Montso/Pi-HAT/Additional Libraries/74LVC125APW_118/74LVC125APW_118.step

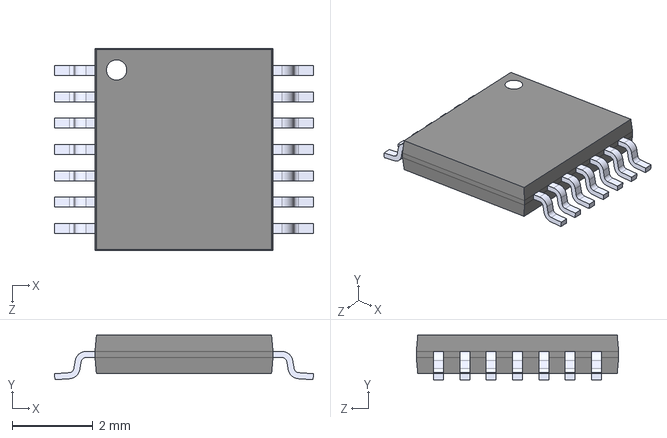
[picture p1: CAD file, 2022-10-23]
Additional Libraries/74LVC125APW_118/74LVC125APW_118.step
6.40 x 1.10 x 5.00 mm
