Montso/Pi-HAT/Additional Libraries/ADC108S022CIMTX_NOPB/ADC108S022CIMTX_NOPB.step

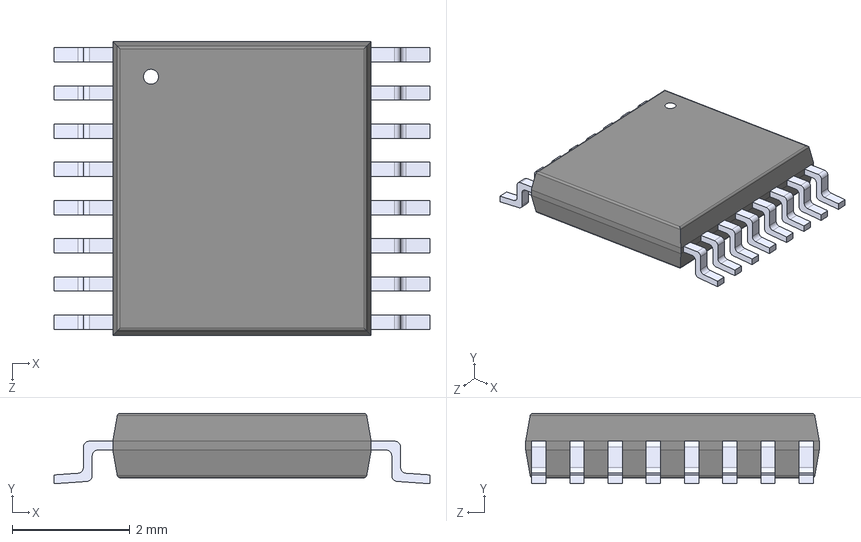
[picture p2: CAD file, 2023-12-06]
Additional Libraries/ADC108S022CIMTX_NOPB/ADC108S022CIMTX_NOPB.step
6.40 x 1.20 x 5.00 mm
