Montso/Pi-HAT/Additional Libraries/TMP235A2DCKR/TMP235A2DCKR.step

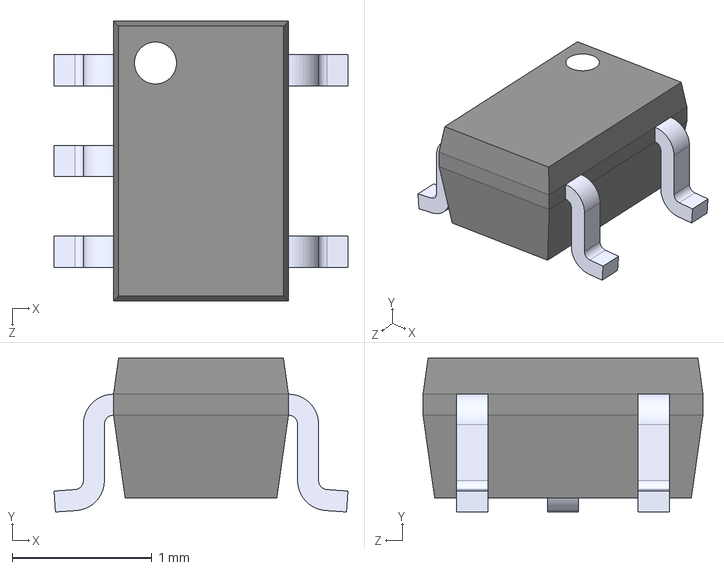
[picture p3: CAD file, 2023-12-06]
Additional Libraries/TMP235A2DCKR/TMP235A2DCKR.step
2.10 x 1.10 x 2.00 mm
