Montso/Pi-HAT/Pi HAT.kicad_pcb

## KiCad design Pi HAT.kicad_pcb (2024-07-01)

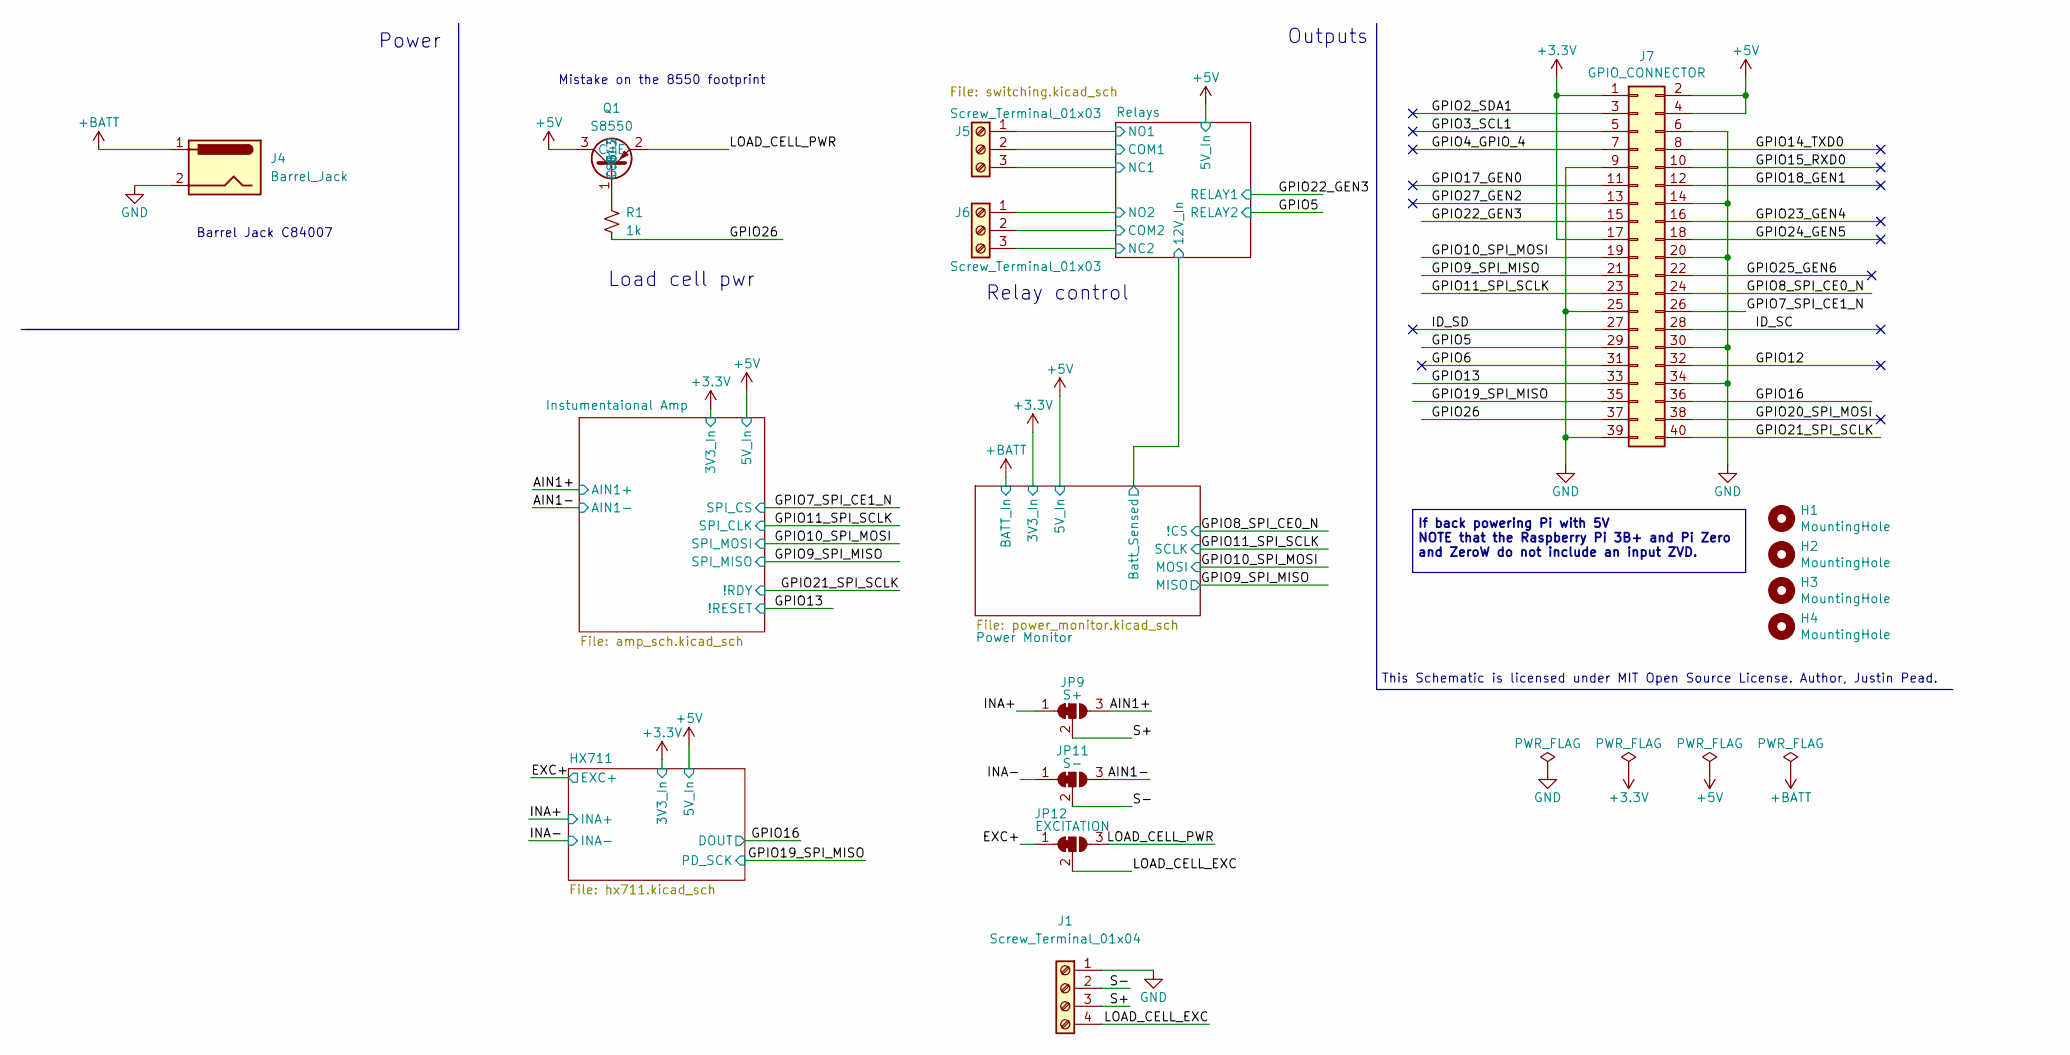
[picture p4: schematic Pi HAT.kicad_sch, Raspberry Pi Zero Intrumentation HAT]

Parts:
H1, H2, H3, H4: MountingHole; MountingHole_2.7mm_M2.5_uHAT_RPi
J1: Screw_Terminal_01x04; TerminalBlock_Phoenix_PT-1,5-4-3.5-H_1x04_P3.50mm_Horizontal; LCSC C5144867
J4: Barrel_Jack; Barrel_Jack_2A_C84007; LCSC C84007
J5, J6: Screw_Terminal_01x03; TerminalBlock_Phoenix_PT-1,5-3-3.5-H_1x03_P3.50mm_Horizontal; LCSC C3816291
J7: GPIO_CONNECTOR; PinSocket_2x20_P2.54mm_Vertical_Centered_Anchor
JP9: S+; SolderJumper-3_P1.3mm_Bridged2Bar12_RoundedPad1.0x1.5mm
JP11: S-; SolderJumper-3_P1.3mm_Bridged2Bar12_RoundedPad1.0x1.5mm
JP12: EXCITATION; SolderJumper-3_P1.3mm_Bridged2Bar12_RoundedPad1.0x1.5mm
Q1: S8550; SOT-23; LCSC C8542
R1: 1k; R_0402_1005Metric; LCSC C11702

Connections:
+3.3V: J7.1, J7.17; also elsewhere on the board
+5V: J7.2, J7.4, Q1.3 (C); also elsewhere on the board
+BATT: J4.1; also elsewhere on the board
/AIN1+: JP9.3 (B); also elsewhere on the board
/AIN1-: JP11.3 (B); also elsewhere on the board
/EXC+: JP12.1 (A); also elsewhere on the board
/GPIO2_SDA1: J7.3
/GPIO3_SCL1: J7.5
/GPIO4_GPIO_4: J7.7
/GPIO5: J7.29; also elsewhere on the board
/GPIO6: J7.31
/GPIO7_SPI_CE1_N: J7.26; also elsewhere on the board
/GPIO8_SPI_CE0_N: J7.24; also elsewhere on the board
/GPIO9_SPI_MISO: J7.21; also elsewhere on the board
/GPIO10_SPI_MOSI: J7.19; also elsewhere on the board
/GPIO11_SPI_SCLK: J7.23; also elsewhere on the board
/GPIO12: J7.32
/GPIO13: J7.33; also elsewhere on the board
/GPIO14_TXD0: J7.8
/GPIO15_RXD0: J7.10
/GPIO16: J7.36; also elsewhere on the board
/GPIO17_GEN0: J7.11
/GPIO18_GEN1: J7.12
/GPIO19_SPI_MISO: J7.35; also elsewhere on the board
/GPIO20_SPI_MOSI: J7.38
/GPIO21_SPI_SCLK: J7.40; also elsewhere on the board
/GPIO22_GEN3: J7.15; also elsewhere on the board
/GPIO23_GEN4: J7.16
/GPIO24_GEN5: J7.18
/GPIO25_GEN6: J7.22
/GPIO26: J7.37, R1.2
/GPIO27_GEN2: J7.13
/ID_SC: J7.28
/ID_SD: J7.27
/INA+: JP9.1 (A); also elsewhere on the board
/INA-: JP11.1 (A); also elsewhere on the board
/LOAD_CELL_EXC: J1.4, JP12.2 (C)
/LOAD_CELL_PWR: JP12.3 (B), Q1.2 (E)
/Relays/COM1: J5.2; also elsewhere on the board
/Relays/COM2: J6.2; also elsewhere on the board
/Relays/NC1: J5.3; also elsewhere on the board
/Relays/NC2: J6.3; also elsewhere on the board
/Relays/NO1: J5.1; also elsewhere on the board
/Relays/NO2: J6.1; also elsewhere on the board
/S+: J1.3, JP9.2 (C)
/S-: J1.2, JP11.2 (C)
GND: J1.1, J4.2, J7.6, J7.9, J7.14, J7.20, J7.25, J7.30, J7.34, J7.39; also elsewhere on the board
unnamed: Q1.1 (B), R1.1

Notes on the sheet:
Barrel Jack C84007
This Schematic is licensed under MIT Open Source License. Author, Justin Pead.
Power
Outputs
If back powering Pi with 5V NOTE that the Raspberry Pi 3B+ and Pi Zero and ZeroW do not include an input ZVD.
Load cell pwr
Mistake on the 8550 footprint
Relay control

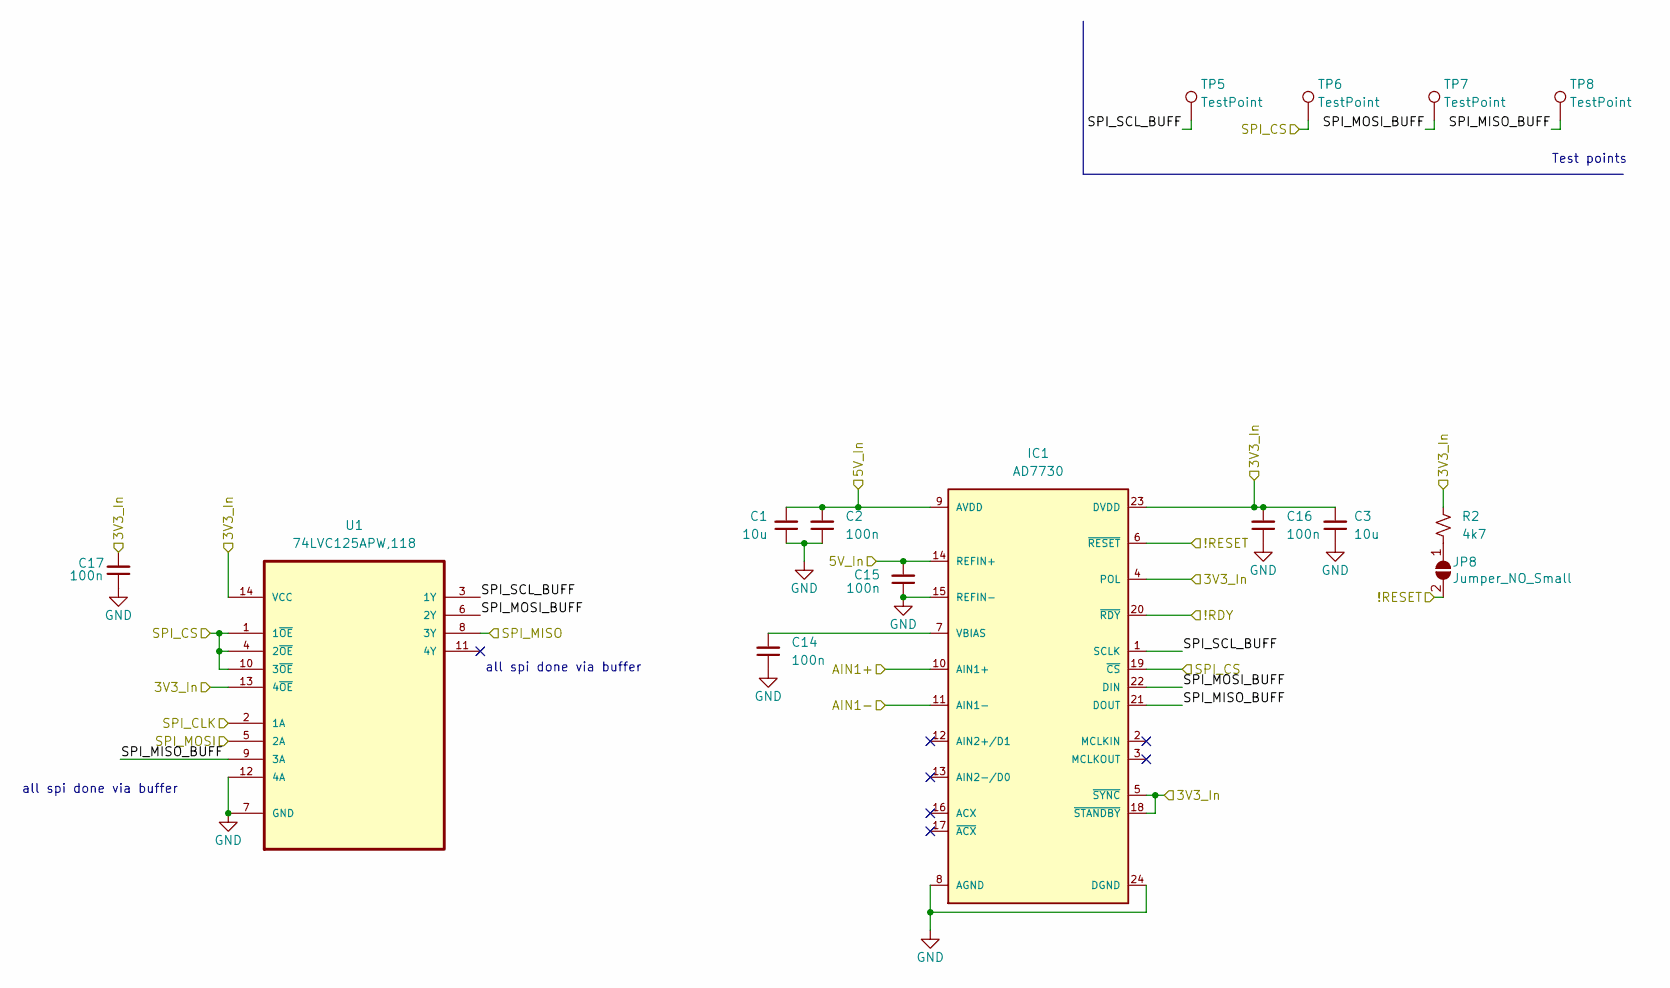
[picture p5: schematic amp_sch.kicad_sch, Raspberry Pi Zero Intrumentation HAT]

Parts:
C1, C3: 10u; C_0603_1608Metric; LCSC C96446
C2, C14, C16, C17: 100n; C_0603_1608Metric
C15: 100n; C_0603_1608Metric; LCSC C96446
IC1: AD7730; TSSOP-24_4.4x7.8mm_P0.65mm
JP8: Jumper_NO_Small; SolderJumper-2_P1.3mm_Open_RoundedPad1.0x1.5mm
R2: 4k7; R_0402_1005Metric; LCSC C25900
TP5, TP6, TP7, TP8: TestPoint; TestPoint_Pad_D1.5mm
U1: 74LVC125APW,118; SOP65P640X110-14N; MPN 74LVC125APW,118; LCSC C6059

Connections:
+3.3V: C3.2, C16.2, C17.2, IC1.4 (POL), IC1.5 (~SYNC), IC1.18 (~STANDBY), IC1.23 (DVDD), R2.2, U1.13 (4~OE), U1.14 (VCC); also elsewhere on the board
+5V: C1.2, C2.2, C15.2, IC1.9 (AVDD), IC1.14 (REFIN+); also elsewhere on the board
/AIN1+: IC1.10 (AIN1+); also elsewhere on the board
/AIN1-: IC1.11 (AIN1-); also elsewhere on the board
/GPIO7_SPI_CE1_N: IC1.19 (~CS), TP6.1, U1.1 (1~OE), U1.4 (2~OE), U1.10 (3~OE); also elsewhere on the board
/GPIO9_SPI_MISO: U1.8 (3Y); also elsewhere on the board
/GPIO10_SPI_MOSI: U1.5 (2A); also elsewhere on the board
/GPIO11_SPI_SCLK: U1.2 (1A); also elsewhere on the board
/GPIO13: IC1.6 (~RESET), JP8.2 (B); also elsewhere on the board
/GPIO21_SPI_SCLK: IC1.20 (~RDY); also elsewhere on the board
/Instumentaional Amp/SPI_MISO_BUFF: IC1.21 (DOUT), TP8.1, U1.9 (3A)
/Instumentaional Amp/SPI_MOSI_BUFF: IC1.22 (DIN), TP7.1, U1.6 (2Y)
/Instumentaional Amp/SPI_SCL_BUFF: IC1.1 (SCLK), TP5.1, U1.3 (1Y)
GND: C1.1, C2.1, C3.1, C14.1, C15.1, C16.1, C17.1, IC1.8 (AGND), IC1.15 (REFIN-), IC1.24 (DGND), U1.7 (GND), U1.12 (4A); also elsewhere on the board
unnamed: C14.2, IC1.7 (VBIAS)
unnamed: JP8.1 (A), R2.1

Notes on the sheet:
all spi done via buffer
Test points

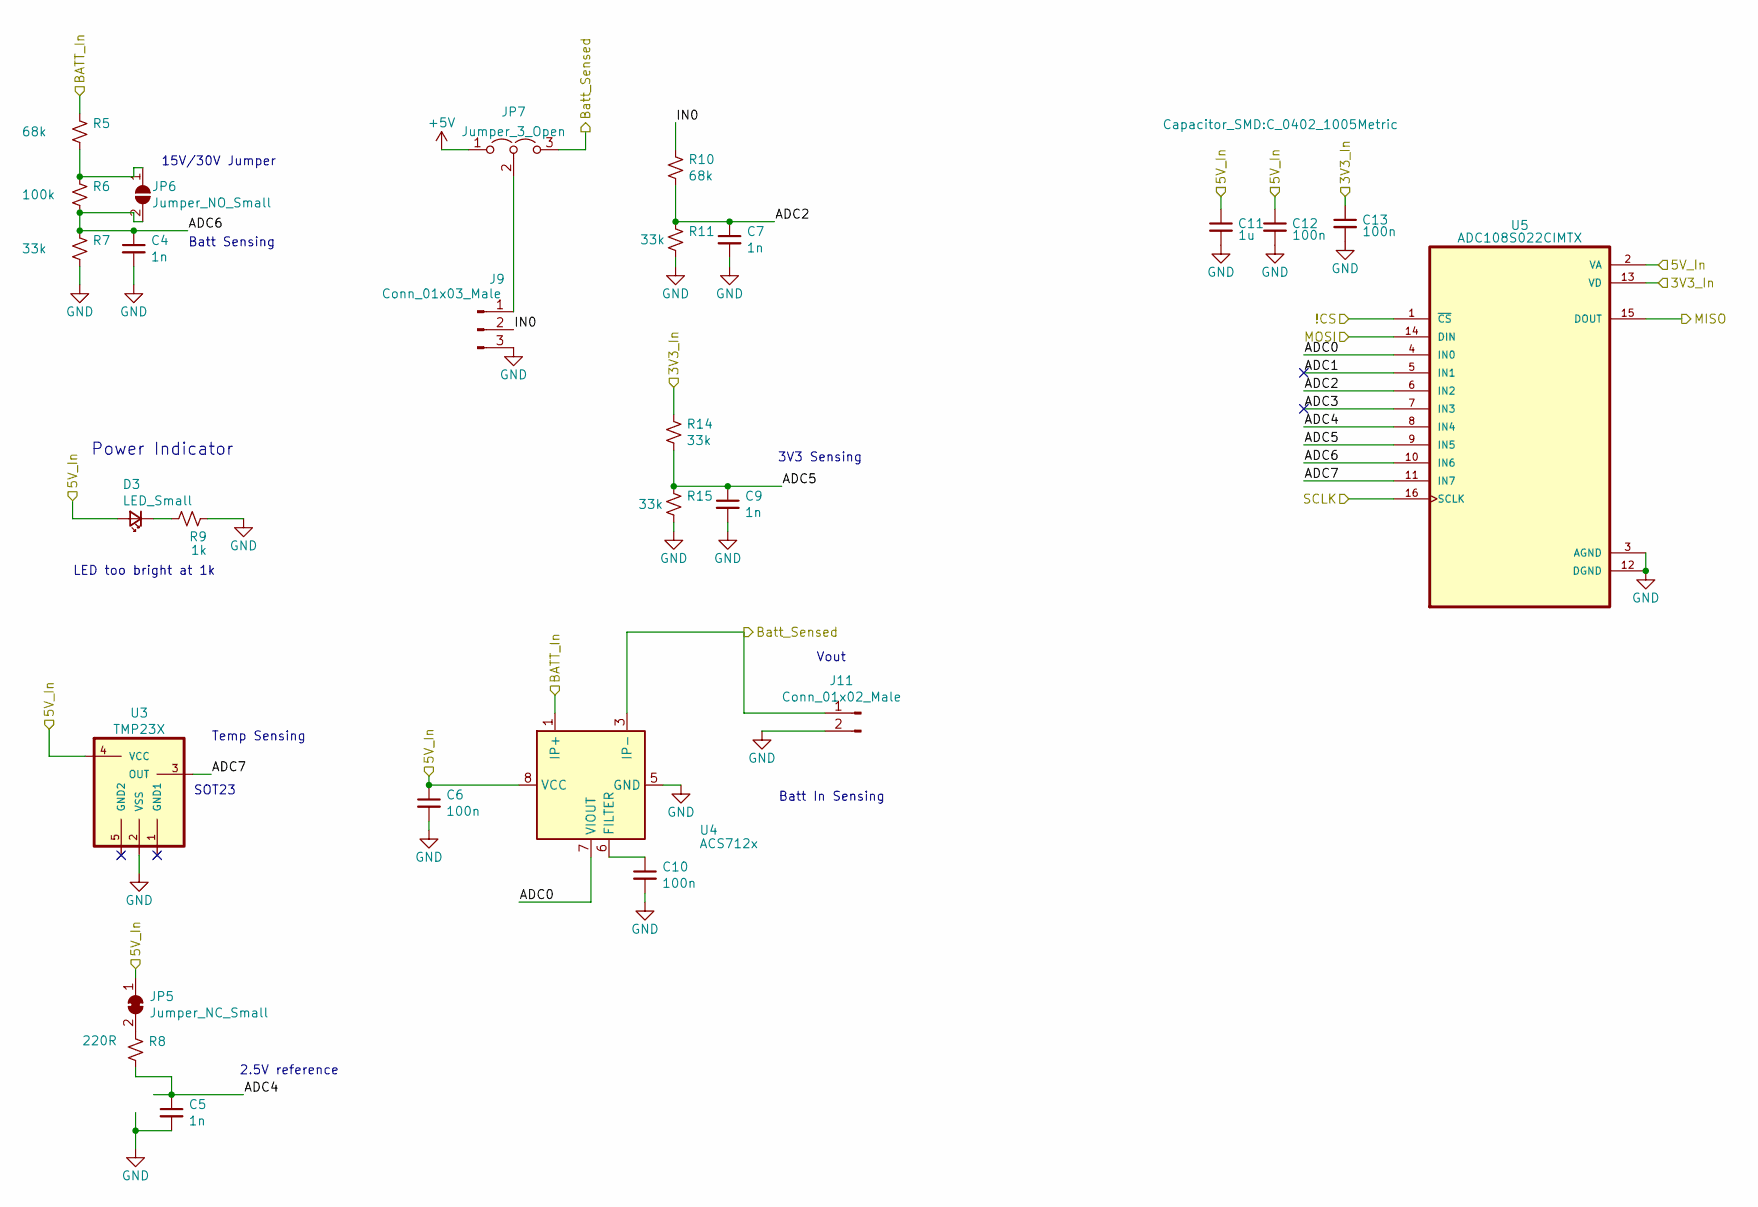
[picture p6: schematic power_monitor.kicad_sch, Raspberry Pi Zero Intrumentation HAT]

Parts:
C4, C5, C7, C9: 1n; C_0402_1005Metric; LCSC C1523
C6, C10, C12, C13: 100n; C_0402_1005Metric; LCSC C307331
C11: 1u; C_0402_1005Metric; LCSC C52923
D3: LED_Small; D_0603_1608Metric; LCSC C2286
J9: Conn_01x03_Male; PinHeader_1x03_P2.54mm_Vertical
J11: Conn_01x02_Male; PinHeader_1x02_P2.54mm_Vertical
JP5: Jumper_NC_Small; SolderJumper-2_P1.3mm_Bridged_RoundedPad1.0x1.5mm
JP6: Jumper_NO_Small; SolderJumper-2_P1.3mm_Open_RoundedPad1.0x1.5mm
JP7: Jumper_3_Open; SolderJumper-3_P2.0mm_Open_TrianglePad1.0x1.5mm
R5, R10: 68k; R_0402_1005Metric; LCSC C36871
R6: 100k; R_0402_1005Metric; LCSC C25741
R7, R11, R14, R15: 33k; R_0402_1005Metric; LCSC C25779
R8: 220R; R_0402_1005Metric; LCSC C25091
R9: 1k; R_0402_1005Metric; LCSC C11702
U3: TMP23X; SOT65P210X110-5N; LCSC C2861437
U4: ACS712x; SOIC-8_3.9x4.9mm_P1.27mm; LCSC C44471
U5: ADC108S022CIMTX; SOP65P640X120-16N; MPN ADC108S022CIMTX

Connections:
+3.3V: C13.1, R14.1, U5.13 (VD); also elsewhere on the board
+5V: C6.1, C11.1, C12.1, D3.2 (A), JP5.1 (A), JP7.1 (A), U3.4 (VCC), U4.8 (VCC), U5.2 (VA); also elsewhere on the board
+BATT: R5.1, U4.1 (IP+), U4.2 (IP+); also elsewhere on the board
/GPIO8_SPI_CE0_N: U5.1 (~CS); also elsewhere on the board
/GPIO9_SPI_MISO: U5.15 (DOUT); also elsewhere on the board
/GPIO10_SPI_MOSI: U5.14 (DIN); also elsewhere on the board
/GPIO11_SPI_SCLK: U5.16 (SCLK); also elsewhere on the board
/Power Monitor/ADC0: U4.7 (VIOUT), U5.4 (IN0)
/Power Monitor/ADC1: U5.5 (IN1)
/Power Monitor/ADC2: C7.1, R10.2, R11.1, U5.6 (IN2)
/Power Monitor/ADC3: U5.7 (IN3)
/Power Monitor/ADC4: C5.1, R8.2, U5.8 (IN4)
/Power Monitor/ADC5: C9.1, R14.2, R15.1, U5.9 (IN5)
/Power Monitor/ADC6: C4.1, JP6.2 (B), R6.2, R7.1, U5.10 (IN6)
/Power Monitor/ADC7: U3.3 (OUT), U5.11 (IN7)
/Power Monitor/Batt_Sensed: J11.1, JP7.3 (B), U4.3 (IP-), U4.4 (IP-); also elsewhere on the board
/Power Monitor/IN0: J9.2, R10.1
GND: C4.2, C5.2, C6.2, C7.2, C9.2, C10.2, C11.2, C12.2, C13.2, J9.3, J11.2, R7.2, R9.2, R11.2, R15.2, U3.2 (VSS), U4.5 (GND), U5.3 (AGND), U5.12 (DGND); also elsewhere on the board
unnamed: D3.1 (K), R9.1
unnamed: J9.1, JP7.2 (C)
unnamed: JP5.2 (B), R8.1
unnamed: JP6.1 (A), R5.2, R6.1
unnamed: C10.1, U4.6 (FILTER)

Notes on the sheet:
SOT23
Power Indicator
3V3 Sensing
Batt In Sensing
2.5V reference
LED too bright at 1k
Temp Sensing
15V/30V Jumper
Vout
Batt Sensing

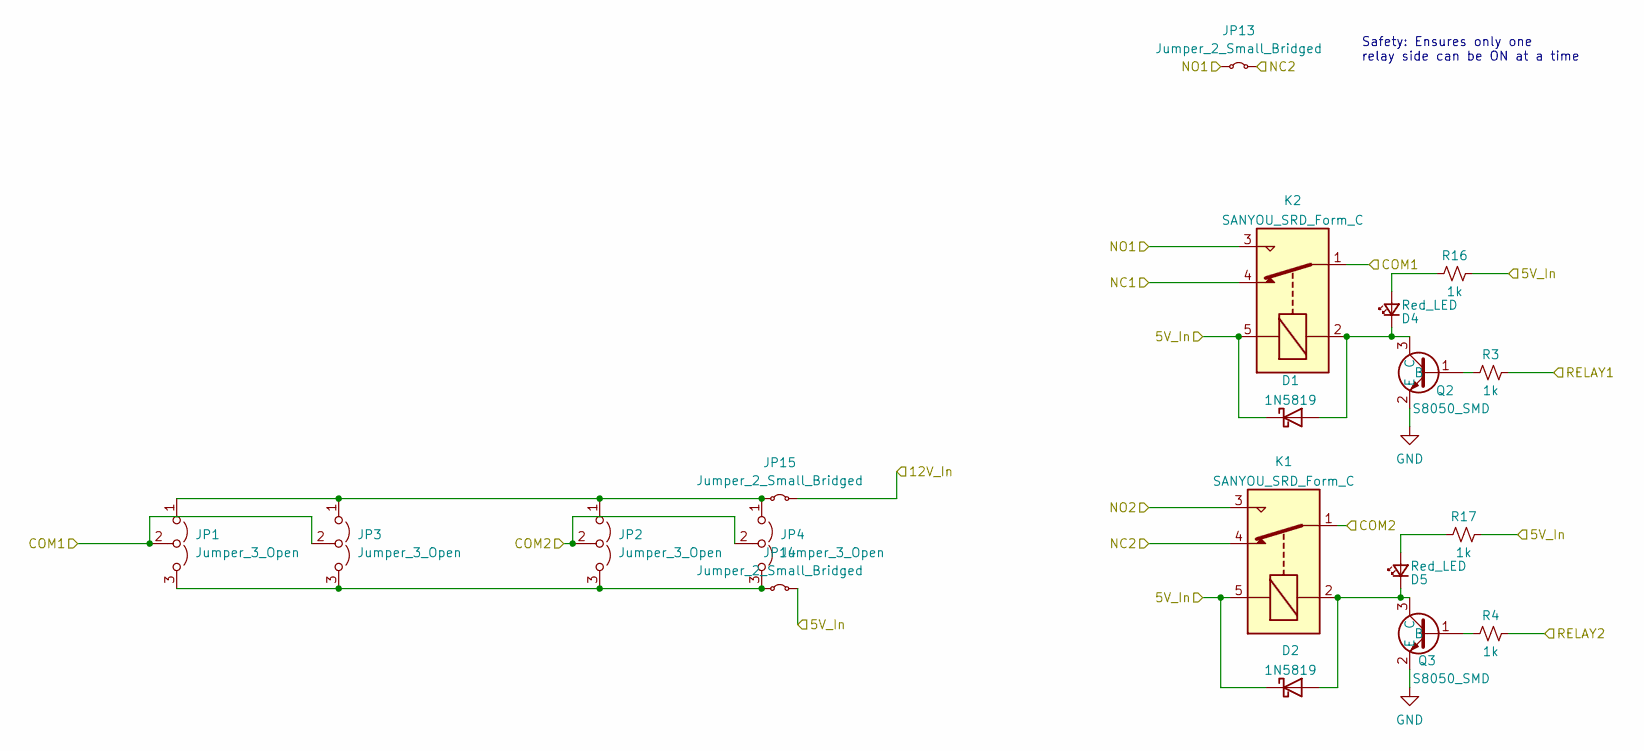
[picture p7: schematic switching.kicad_sch, Raspberry Pi Zero Intrumentation HAT]

Parts:
D1, D2: 1N5819; D_SOD-123; LCSC C8598
D4, D5: Red_LED; D_0603_1608Metric; LCSC C2286
JP1, JP2, JP3, JP4: Jumper_3_Open; SolderJumper-3_P2.0mm_Open_TrianglePad1.0x1.5mm
JP13: Jumper_2_Small_Bridged; SolderJumper-2_P1.3mm_Bridged_RoundedPad1.0x1.5mm
JP14, JP15: Jumper_2_Small_Bridged; Jumper_Open_wide
K1, K2: SANYOU_SRD_Form_C; Relay_SPDT_SANYOU_SRD_Series_Form_C; LCSC C35449
Q2, Q3: S8050_SMD; SOT-23; LCSC C2150
R3, R4, R16, R17: 1k; R_0402_1005Metric; LCSC C11702

Connections:
+5V: D1.1 (K), D2.1 (K), JP14.2 (B), K1.5, K2.5, R16.2, R17.2; also elsewhere on the board
/GPIO5: R4.2; also elsewhere on the board
/GPIO22_GEN3: R3.2; also elsewhere on the board
/Power Monitor/Batt_Sensed: JP15.2 (B); also elsewhere on the board
/Relays/COM1: JP1.2 (C), JP3.2 (C), K2.1; also elsewhere on the board
/Relays/COM2: JP2.2 (C), JP4.2 (C), K1.1; also elsewhere on the board
/Relays/NC1: K2.4; also elsewhere on the board
/Relays/NC2: JP13.2 (B), K1.4; also elsewhere on the board
/Relays/NO1: JP13.1 (A), K2.3; also elsewhere on the board
/Relays/NO2: K1.3; also elsewhere on the board
GND: Q2.2 (E), Q3.2 (E); also elsewhere on the board
unnamed: D1.2 (A), D4.1 (K), K2.2, Q2.3 (C)
unnamed: D2.2 (A), D5.1 (K), K1.2, Q3.3 (C)
unnamed: D4.2 (A), R16.1
unnamed: D5.2 (A), R17.1
unnamed: JP1.1 (A), JP2.1 (A), JP3.1 (A), JP4.1 (A), JP15.1 (A)
unnamed: JP1.3 (B), JP2.3 (B), JP3.3 (B), JP4.3 (B), JP14.1 (A)
unnamed: Q2.1 (B), R3.1
unnamed: Q3.1 (B), R4.1

Notes on the sheet:
Safety: Ensures only one relay side can be ON at a time

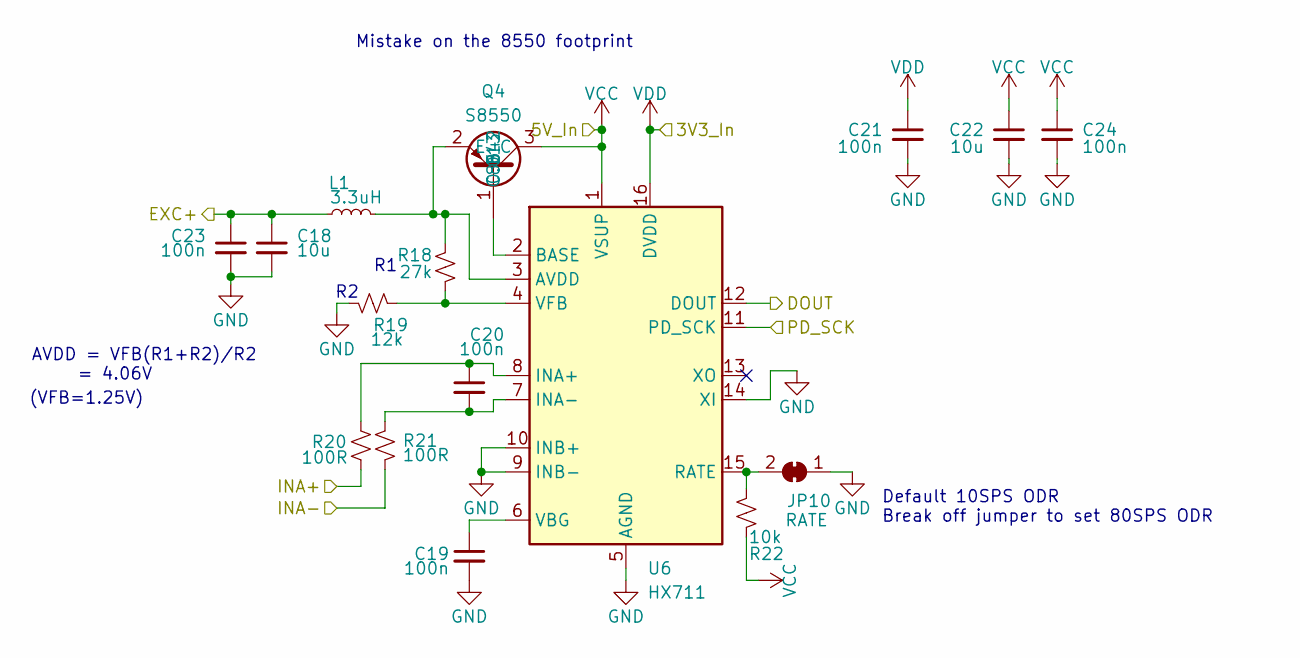
[picture p8: schematic hx711.kicad_sch, Raspberry Pi Zero Intrumentation HAT]

Parts:
C18, C22: 10u; C_0603_1608Metric
C19, C20, C21, C24: 100n; C_0402_1005Metric
C23: 100n; C_0603_1608Metric
JP10: RATE; SolderJumper-2_P1.3mm_Bridged_RoundedPad1.0x1.5mm
L1: 3.3uH; L_0603_1608Metric
Q4: S8550; SOT-23; LCSC C8542
R18: 27k; R_0402_1005Metric
R19: 12k; R_0402_1005Metric
R20, R21: 100R; R_0402_1005Metric
R22: 10k; R_0402_1005Metric
U6: HX711; SOP-16_3.9x9.9mm_P1.27mm

Connections:
+3.3V: C21.1, U6.16 (DVDD); also elsewhere on the board
+5V: C22.1, C24.1, Q4.3 (C), R22.2, U6.1 (VSUP); also elsewhere on the board
/EXC+: C18.1, C23.1, L1.1; also elsewhere on the board
/GPIO16: U6.12 (DOUT); also elsewhere on the board
/GPIO19_SPI_MISO: U6.11 (PD_SCK); also elsewhere on the board
/INA+: R20.1; also elsewhere on the board
/INA-: R21.1; also elsewhere on the board
GND: C18.2, C19.2, C21.2, C22.2, C23.2, C24.2, JP10.1 (A), R19.1, U6.5 (AGND), U6.9 (INB-), U6.10 (INB+), U6.14 (XI); also elsewhere on the board
unnamed: JP10.2 (B), R22.1, U6.15 (RATE)
unnamed: Q4.1 (B), U6.2 (BASE)
unnamed: L1.2, Q4.2 (E), R18.1, U6.3 (AVDD)
unnamed: C20.1, R20.2, U6.8 (INA+)
unnamed: C20.2, R21.2, U6.7 (INA-)
unnamed: C19.1, U6.6 (VBG)
unnamed: R18.2, R19.2, U6.4 (VFB)

Notes on the sheet:
Default 10SPS ODR Break off jumper to set 80SPS ODR
AVDD = VFB(R1+R2)/R2 = 4.06V
(VFB=1.25V)
Mistake on the 8550 footprint

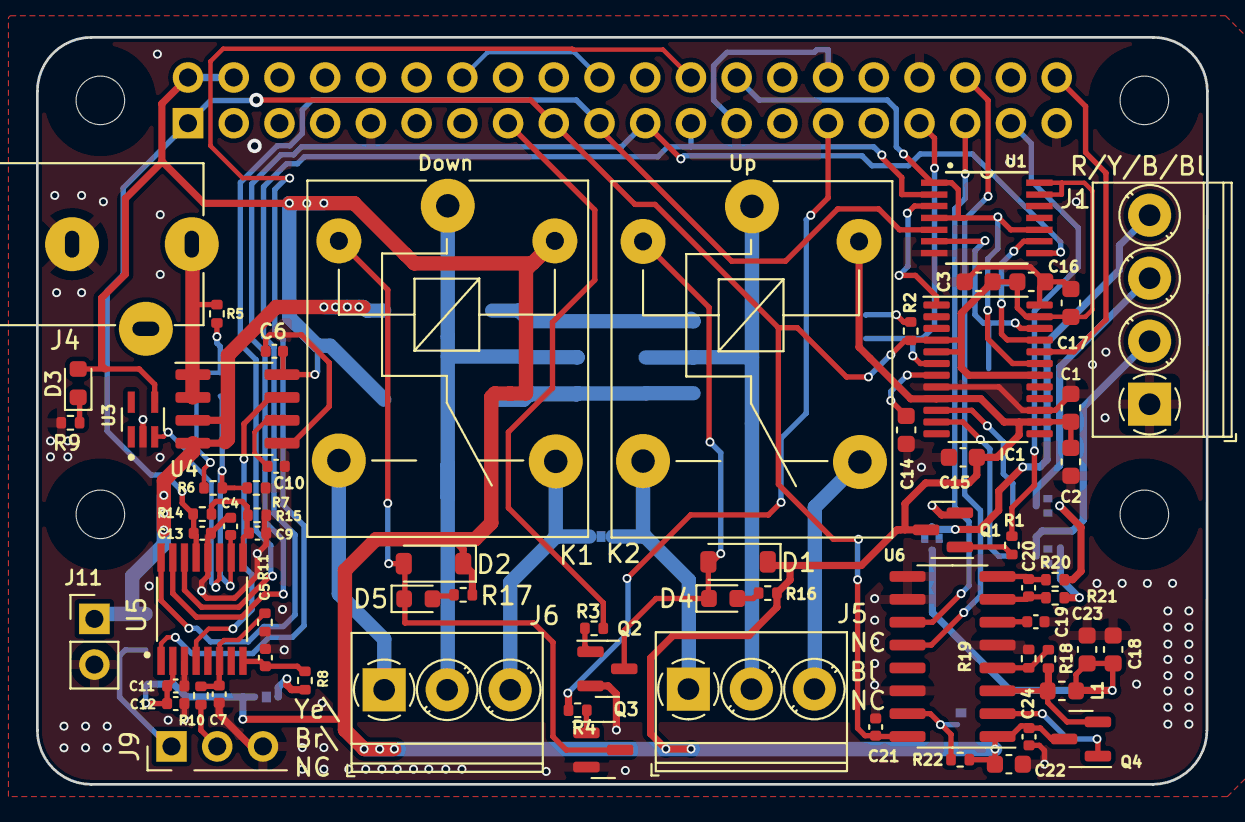
[picture p9: board Pi HAT.kicad_pcb from above]

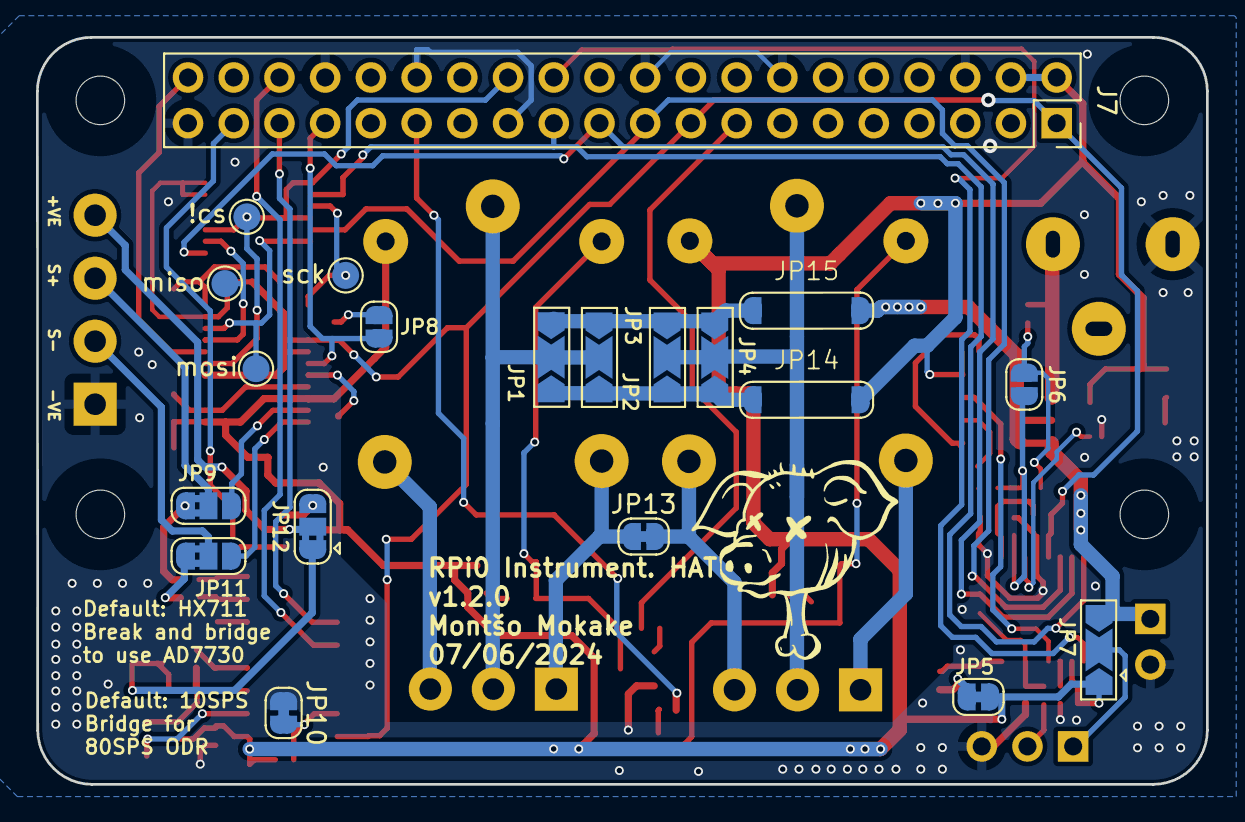
[picture p10: board Pi HAT.kicad_pcb from below]

Board: 2 copper layers, 65.0 x 41.5 mm, 91 parts (20 on the bottom side), 65 nets.
