Montso/Pi-HAT/(commit log)

2022-10-29 Footprint assignment
    Footprints yet to be assigned:
    -U1: 74LVC125APW
    [Pi HAT.kicad_pcb, Pi HAT.kicad_sch, amp_sch.kicad_sch, power_monitor.kicad_sch, switching.kicad_sch]
2022-11-01 Buffer footprint added
    -fault in footprint for pi headers and load cell headers
    [Pi HAT.kicad_sch, amp_sch.kicad_sch, power_monitor.kicad_sch]
2022-11-03 FIxed J1-Headers conflict
    Added a layout
    [Pi HAT.kicad_sch, amp_sch.kicad_sch, power_monitor.kicad_sch]
2022-11-11 Component placement
    [Pi HAT.kicad_pcb, Pi HAT.kicad_sch, amp_sch.kicad_sch, power_monitor.kicad_sch]
2022-11-12 Reassigned pins to match placement
    [Pi HAT.kicad_pcb, Pi HAT.kicad_sch, amp_sch.kicad_sch, power_monitor.kicad_sch, switching.kicad_sch]
2022-11-17 Flipping components to the front side
    [Pi HAT.kicad_pcb]
2022-11-20 placement refinement and indicator LEDs for relays
    -Crude wiring
    -Fixed values
    -Indicator LEDs for relays
    -Added test points
    [Pi HAT.kicad_pcb, Pi HAT.kicad_sch, amp_sch.kicad_sch, power_monitor.kicad_sch, switching.kicad_sch]
2022-11-24 Update Pi HAT.kicad_pcb
    [Pi HAT.kicad_pcb]
2022-11-24 Wiring and 12V battery_sensed added
    [Pi HAT.kicad_pcb, Pi HAT.kicad_sch, power_monitor.kicad_sch]
2022-11-24 Updated with changes from meeting
    [Pi HAT.kicad_pcb, power_monitor.kicad_sch]
2022-12-01 Updated wiring. Test points only added for AD7730.
    [Pi HAT.kicad_pcb, Pi HAT.kicad_sch, power_monitor.kicad_sch]
2022-12-01 Updated wiring.
    [Pi HAT.kicad_pcb]
2022-12-07 Updated via sizes on wiring.
    [Pi HAT.kicad_pcb]
2022-12-08 Used Phoenix connectors. Wired ADC0 track.
    [Pi HAT.kicad_pcb, Pi HAT.kicad_sch]
2022-12-08 Fixed CE pins. Added GND copper pour on F.Cu.
    [Pi HAT.kicad_pcb, Pi HAT.kicad_sch, amp_sch.kicad_sch, power_monitor.kicad_sch, switching.kicad_sch]
2022-12-18 Review and fixes on schematic and pcb.
    -Updated Relay LED values.
    -Fixed !RDY and R1 pin conflict on GPIO26.
    [Pi HAT.kicad_pcb, Pi HAT.kicad_sch, amp_sch.kicad_sch, power_monitor.kicad_sch, switching.kicad_sch]
2023-01-16 Improvements made to the info in the schematic excel sheet and made the files necessary for production
    [JLCSMT_Sample_CPL1(1).xlsx, Pi HAT-B_Cu.gbr, Pi HAT-B_Mask.gbr, Pi HAT-B_Paste.gbr, Pi HAT-B_Silkscreen.gbr, Pi HAT-Edge_Cuts.gbr, Pi HAT-F_Cu.gbr, Pi HAT-F_Mask.gbr]
2023-11-22 Changes to the AD7730 based on Montso's working Arduino system
    [Pi HAT.kicad_sch, amp_sch.kicad_sch, power_monitor.kicad_sch, switching.kicad_sch]
2023-12-05 Changes made to the AD7730 circuit. HX711 circuit added and AD7730 sidestepped.
    [Pi HAT.kicad_sch, amp_sch.kicad_sch, hx711.kicad_sch, power_monitor.kicad_sch, switching.kicad_sch]
2023-12-06 Created a folder of additional component libraries
    [74LVC125APW_118.step, ADC108S022CIMTX_NOPB.step, TMP235A2DCKR.step]
2023-12-06 Deleted individual library directories
    [74LVC125APW_118.step]
2023-12-06 Added footprints for HX711 circuit on PCB and modified pin assignment
    [Pi HAT.kicad_pcb, Pi HAT.kicad_sch, amp_sch.kicad_sch, hx711.kicad_sch, power_monitor.kicad_sch, switching.kicad_sch]
2023-12-07 Fixed clearance violations and via sizing violations on pcb. Omitted 'mask aperture bridges' errors for jumpers.
    [Pi HAT.kicad_pcb, Pi HAT.kicad_sch, switching.kicad_sch]
2023-12-07 Made more pcb connections and edited footprints' silkscreens
2023-12-08 Added ground pour and fixed connections
    [Pi HAT.kicad_pcb, Pi HAT.kicad_sch]
2023-12-08 Updated +3V3 tracks on pcb and buffer schematic
    -Added decoupling cap for buffer
    -Tied unused buffer input 4 to gnd
    -Did all +3V3 connections
    -Fixed +5V tracks
    -gnd stitching
    [Pi HAT.kicad_pcb, amp_sch.kicad_sch]
2023-12-08 Updated power circuit. Fixed U1 footprint.
    -Dropped ADC1 and ADC3 connections
    -Dropped IN1 branch
    [Pi HAT.kicad_pcb, power_monitor.kicad_sch]
2023-12-08 Silkscreen labelling
    [Pi HAT.kicad_pcb, power_monitor.kicad_sch]
2023-12-08 Connected power to relay COMs
    [Pi HAT-CuBottom.gbr, Pi HAT-CuTop.gbr, Pi HAT-EdgeCuts.gbr, Pi HAT-MaskBottom.gbr, Pi HAT-MaskTop.gbr, Pi HAT-NPTH.drl, Pi HAT-PTH.drl, Pi HAT-PasteBottom.gbr]
2023-12-09 Fixed HX711 decoupling cap. Changed EXC+.
    - Changed EXC+ to 4.06V
    - Consistent values for schematic components
    - Added B.silkscreen art
    [Pi HAT.kicad_pcb, Pi HAT.kicad_sch, amp_sch.kicad_sch, hx711.kicad_sch]
2023-12-09 Fixed JP10 jumper footprint
    [Pi HAT.kicad_pcb, hx711.kicad_sch]
2023-12-09 Touch ups following final review.
    [Pi HAT.kicad_pcb]
2023-12-09 Added jlcpcb files. Updated additional libraries
    [Pi HAT-CuBottom.gbr, Pi HAT-CuTop.gbr, Pi HAT-EdgeCuts.gbr, Pi HAT-MaskBottom.gbr, Pi HAT-MaskTop.gbr, Pi HAT-NPTH.drl, Pi HAT-PTH.drl, Pi HAT-PasteBottom.gbr]
2023-12-12 Fixed jlcpcb folder
    [Pi HAT-CuBottom.gbr, Pi HAT-CuTop.gbr, Pi HAT-EdgeCuts.gbr, Pi HAT-MaskBottom.gbr, Pi HAT-MaskTop.gbr, Pi HAT-NPTH.drl, Pi HAT-PTH.drl, Pi HAT-PasteBottom.gbr]
2023-12-12 Added jlcpcb files. Removed .csv in ignore.
    [BOM-Pi HAT.csv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]
2023-12-12 Recovered GERBER-Pi HAT.zip
2023-12-12 Updated BOM. Add parts for pin headers.
    [BOM-Pi HAT.csv]
2023-12-14 Redone BOM. Uploaded jlcpcb files.
    [BOM-Pi HAT.csv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]
2023-12-14 Changed to 5A variant for current sensor.
    [BOM-Pi HAT.csv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]
2023-12-14 Added silkscreen for U1 footprint.
    [BOM-Pi HAT.csv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]
2024-01-10 Minor tweaks on the board, board pullback, and 8550 error spotted
    [Pi HAT.kicad_pcb, Pi HAT.kicad_sch, hx711.kicad_sch]
2024-01-12 Changed some of the wiring on the Jumpers, and changed the footprint for the 8550
    [Pi HAT.kicad_sch, hx711.kicad_sch]
2024-01-15 Added rev number for last changes (ad0cc53)
    [Pi HAT.kicad_sch, amp_sch.kicad_sch, hx711.kicad_sch, power_monitor.kicad_sch, switching.kicad_sch]
2024-01-19 Update BJT symbols and ver number
    [Pi HAT.kicad_sch, amp_sch.kicad_sch, hx711.kicad_sch, power_monitor.kicad_sch, switching.kicad_sch]
2024-01-19 Fixed BJT footprints and adc bridges
    -1.1.x Fixed the BJT pinouts
    -1.1.1 Fixed connections for adc jumpers
    -1.1.2 Add keep-out zone near relay jumpers
    [Pi HAT.kicad_pcb]
2024-01-19 Added gnd stitching vias. Fixed 5v track
    [Pi HAT.kicad_pcb]
2024-06-07 Connected NC2 to COM1
    [Pi HAT.kicad_sch]
2024-06-07 Connected NO2 to COM1. Annonated relays.
    [Pi HAT.kicad_pcb, amp_sch.kicad_sch, hx711.kicad_sch, power_monitor.kicad_sch, switching.kicad_sch]
2024-06-24 Ammended it to have the jumper connection
    [Pi HAT.kicad_pcb, Pi HAT.kicad_sch, amp_sch.kicad_sch, hx711.kicad_sch, power_monitor.kicad_sch, switching.kicad_sch]
2024-07-01 Modified the PCB to have a greater spacing on anything Relay 2ndary side related
    [Pi HAT.kicad_pcb, switching.kicad_sch]
